csanchez126/IFT3150-Projet-AutoCaf-/docs/img/schema.jpg

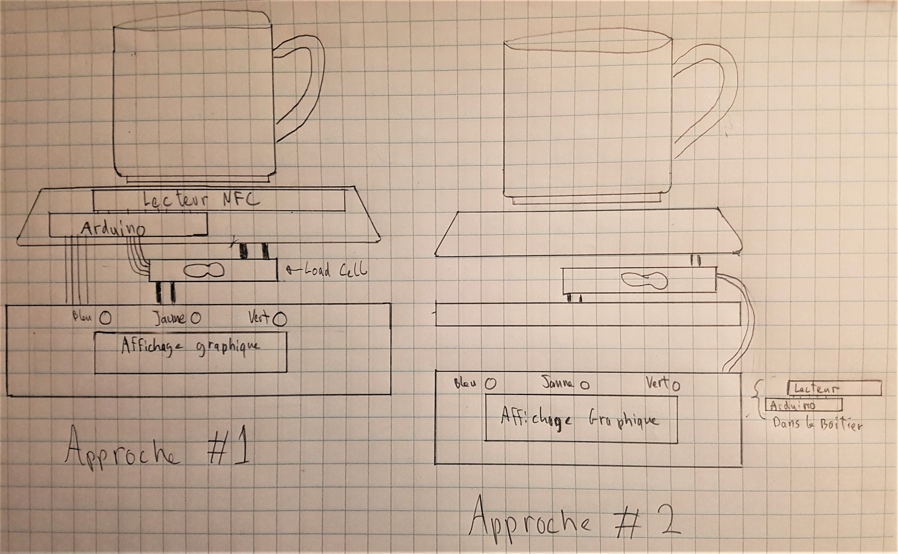
docs/img/schema.jpg
