csanchez126/IFT3150-Projet-AutoCaf-/docs/img/proto_tout.jpg

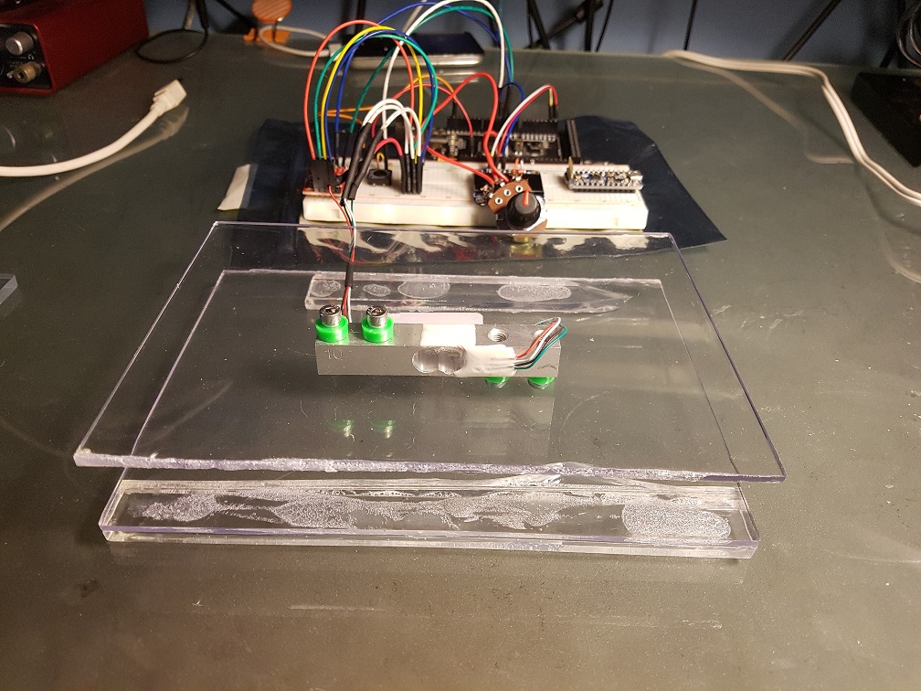
docs/img/proto_tout.jpg
