csanchez126/IFT3150-Projet-AutoCaf-/docs/img/proto_electronique.jpg

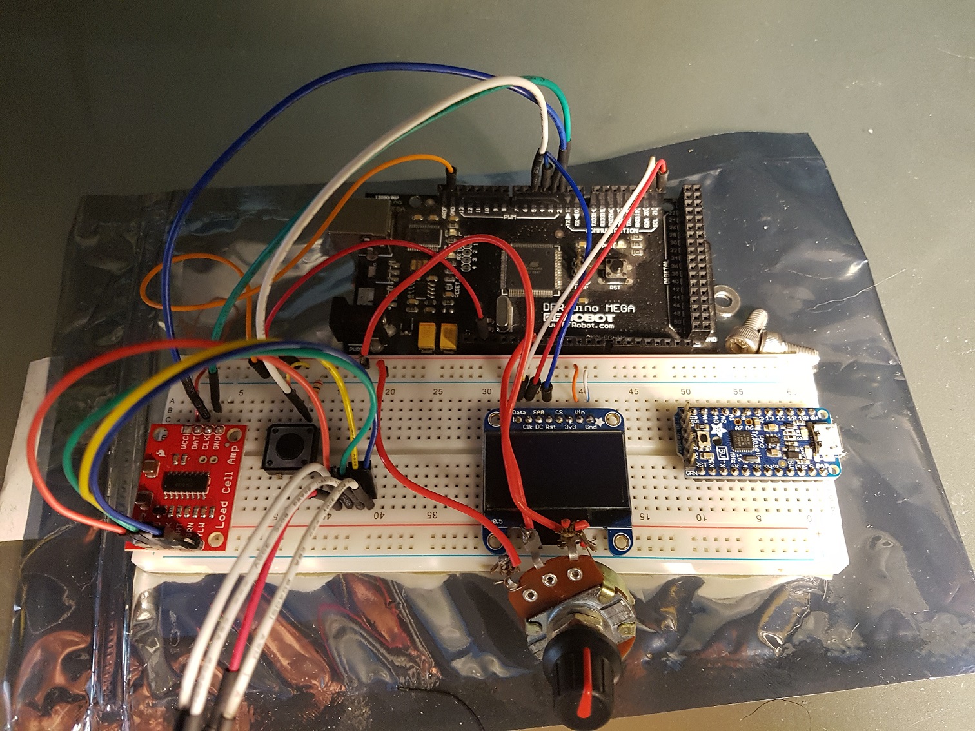
docs/img/proto_electronique.jpg
