csanchez126/IFT3150-Projet-AutoCaf-/docs/img/proto_profil.jpg

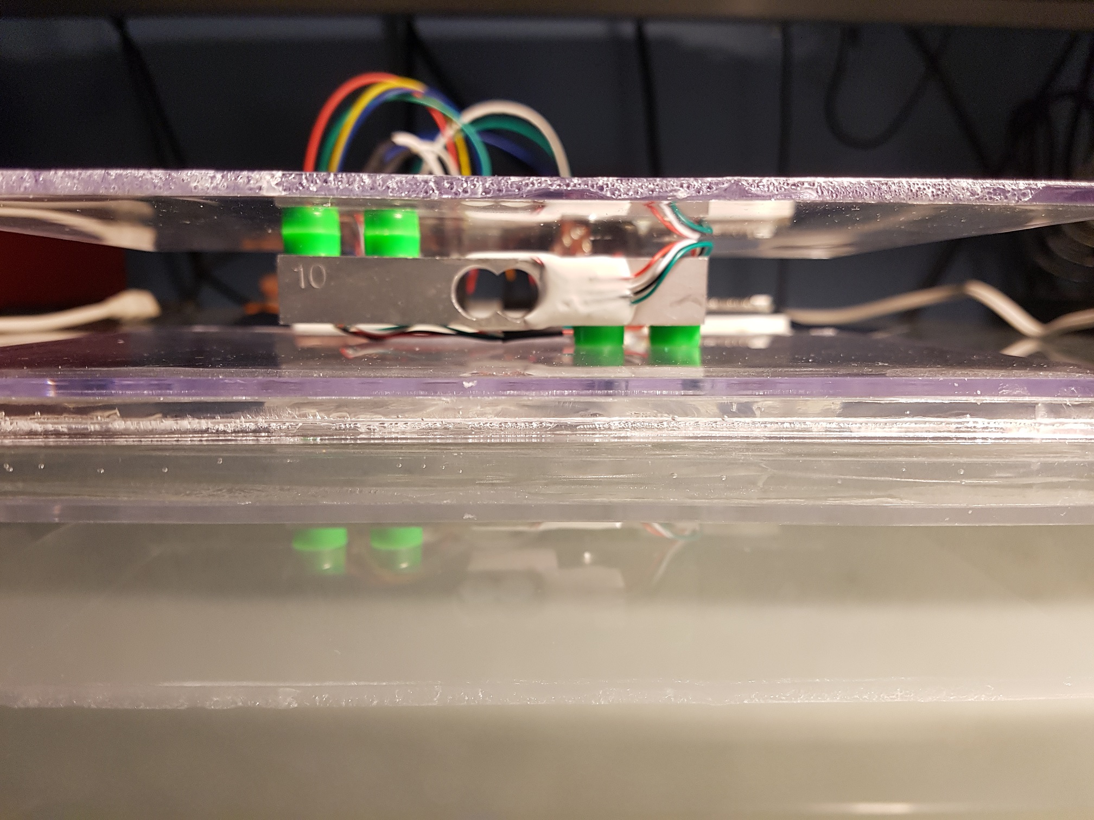
docs/img/proto_profil.jpg
