csanchez126/IFT3150-Projet-AutoCaf-/openscad/plateau.scad

use <composants.scad>;

$fn=128;


module masque() {
    hull() { children(); }
}



module base(diam=130) {
    //render()
    difference() {
        cylinder(d=diam,h=4);
        masque() NFCsupport();
        masque() translate([0,-45,0]) LEDsupport();

    }

    NFCsupport();
    intersection() {
        cylinder(d=diam,h=20,center=true);
        translate([0,-45,0]) LEDsupport();
    }

}

module insere() {
        difference() {
            children(0);
            hull() scale([1,1,1.01]) children(1);
        }
        children(1);
}

module baseBas(diam=160) {
    difference() {
        translate([0,0,0]) cylinder(d=diam,h=6);
        *for(i=[-2:2]) {
            rotate([0,0,0+180+60*i])
                translate([50/160*diam,0,0])
                cylinder(d=45/160*diam,h=100,center=true);
        }
        for(i=[-4:6]) {
            rotate([0,0,0+180+30*i-30])
                translate([55/160*diam,0,0])
                cylinder(d=15/160*diam,h=100,center=true);
        }
        cylinder(d=45/160*diam,h=100,center=true);
    } 
}

//
// couvercle
//
module couvercle(topD=130,bottomD=160,H=22,ep=2) {
    difference() {
        hull() {
            cylinder(d=topD+ep+1,h=4+ep);
            translate([0,0,-H]) cylinder(d=bottomD+ep+1,h=1);
            ecranSimple();
        }
        translate([0,0,-1]) cylinder(d=topD+1,h=4+1+0.25);
        hull() {
            cylinder(d=topD+1,h=2);
            translate([0,0,-H-0.1]) cylinder(d=bottomD,h=1);
            ecranSimple();
        }
        translate([0,0,1.5]) children();
    }
    
}

module rebord(diam=160,extraD=30,extraH=5) {
    difference() {
        hull() {
            cylinder(d=diam,h=5+extraH);
            cylinder(d=diam+extraD,h=1);
        }
        cylinder(d=diam-4,h=30,center=true);
    }
}


// pour voir seulement la moitie de l'objet...
module cut() {
    intersection() {
        translate([-100,0,-100]) cube([200,200,200]);
        children();
    }
}

module flip() {
    rotate([180,0,0]) children();
}


//
// couvercle
//

//translate([0,0,40])
//cut()
//flip()
*color("yellow") couvercle(ep=1) deplace() rebord(diam=160-10);

//
// plateau balance du haut
//

//flip()
*union() {
    base(diam=130);
    poidsA();
}

// barre de la balance
//%poidsBarre();

//
// plateau balance du bas
//
union() {
    insere() {
        deplace() baseBas(diam=160);
        poidsB();
    }
    deplace() rebord(diam=160-10);
}


module ecran() {
    difference() {
        union() {
            color("blue") translate([0,0,-2.5]) cube([29.5,14.7,5],center=true);
            translate([0,0,-3]) cube([35,35,5],center=true);
        }
        for(i=[-1,1]) {
            for(j=[-1,1]) {
                translate([i*29.5/2,j*29/2,0]) cylinder(d=2.5,h=20,center=true);
            }
        } 
    }
}
module ecranSimple() {
    translate([0,0,-3]) cube([35,35,5],center=true);
}


*translate([0,-80,-8])
rotate([45,0,0]) ecranSimple();
