csanchez126/IFT3150-Projet-AutoCaf-/(commit log)

2017-06-29 un debut de 3d
    [plateau.scad]
2017-07-26 debut de plateau 3d
    [composants.scad, plateau.scad]
2017-07-27 ajout du couvercle 3d
    [composants.scad, plateau.scad]
2017-08-10 plateau plus solide
    [composants.scad, plateau.scad]
